RawanElsayed00/DAWG_ServoDriver_Board/DAWG_ServoDriver.kicad_pcb

## KiCad design DAWG_ServoDriver.kicad_pcb (2024-05-08)

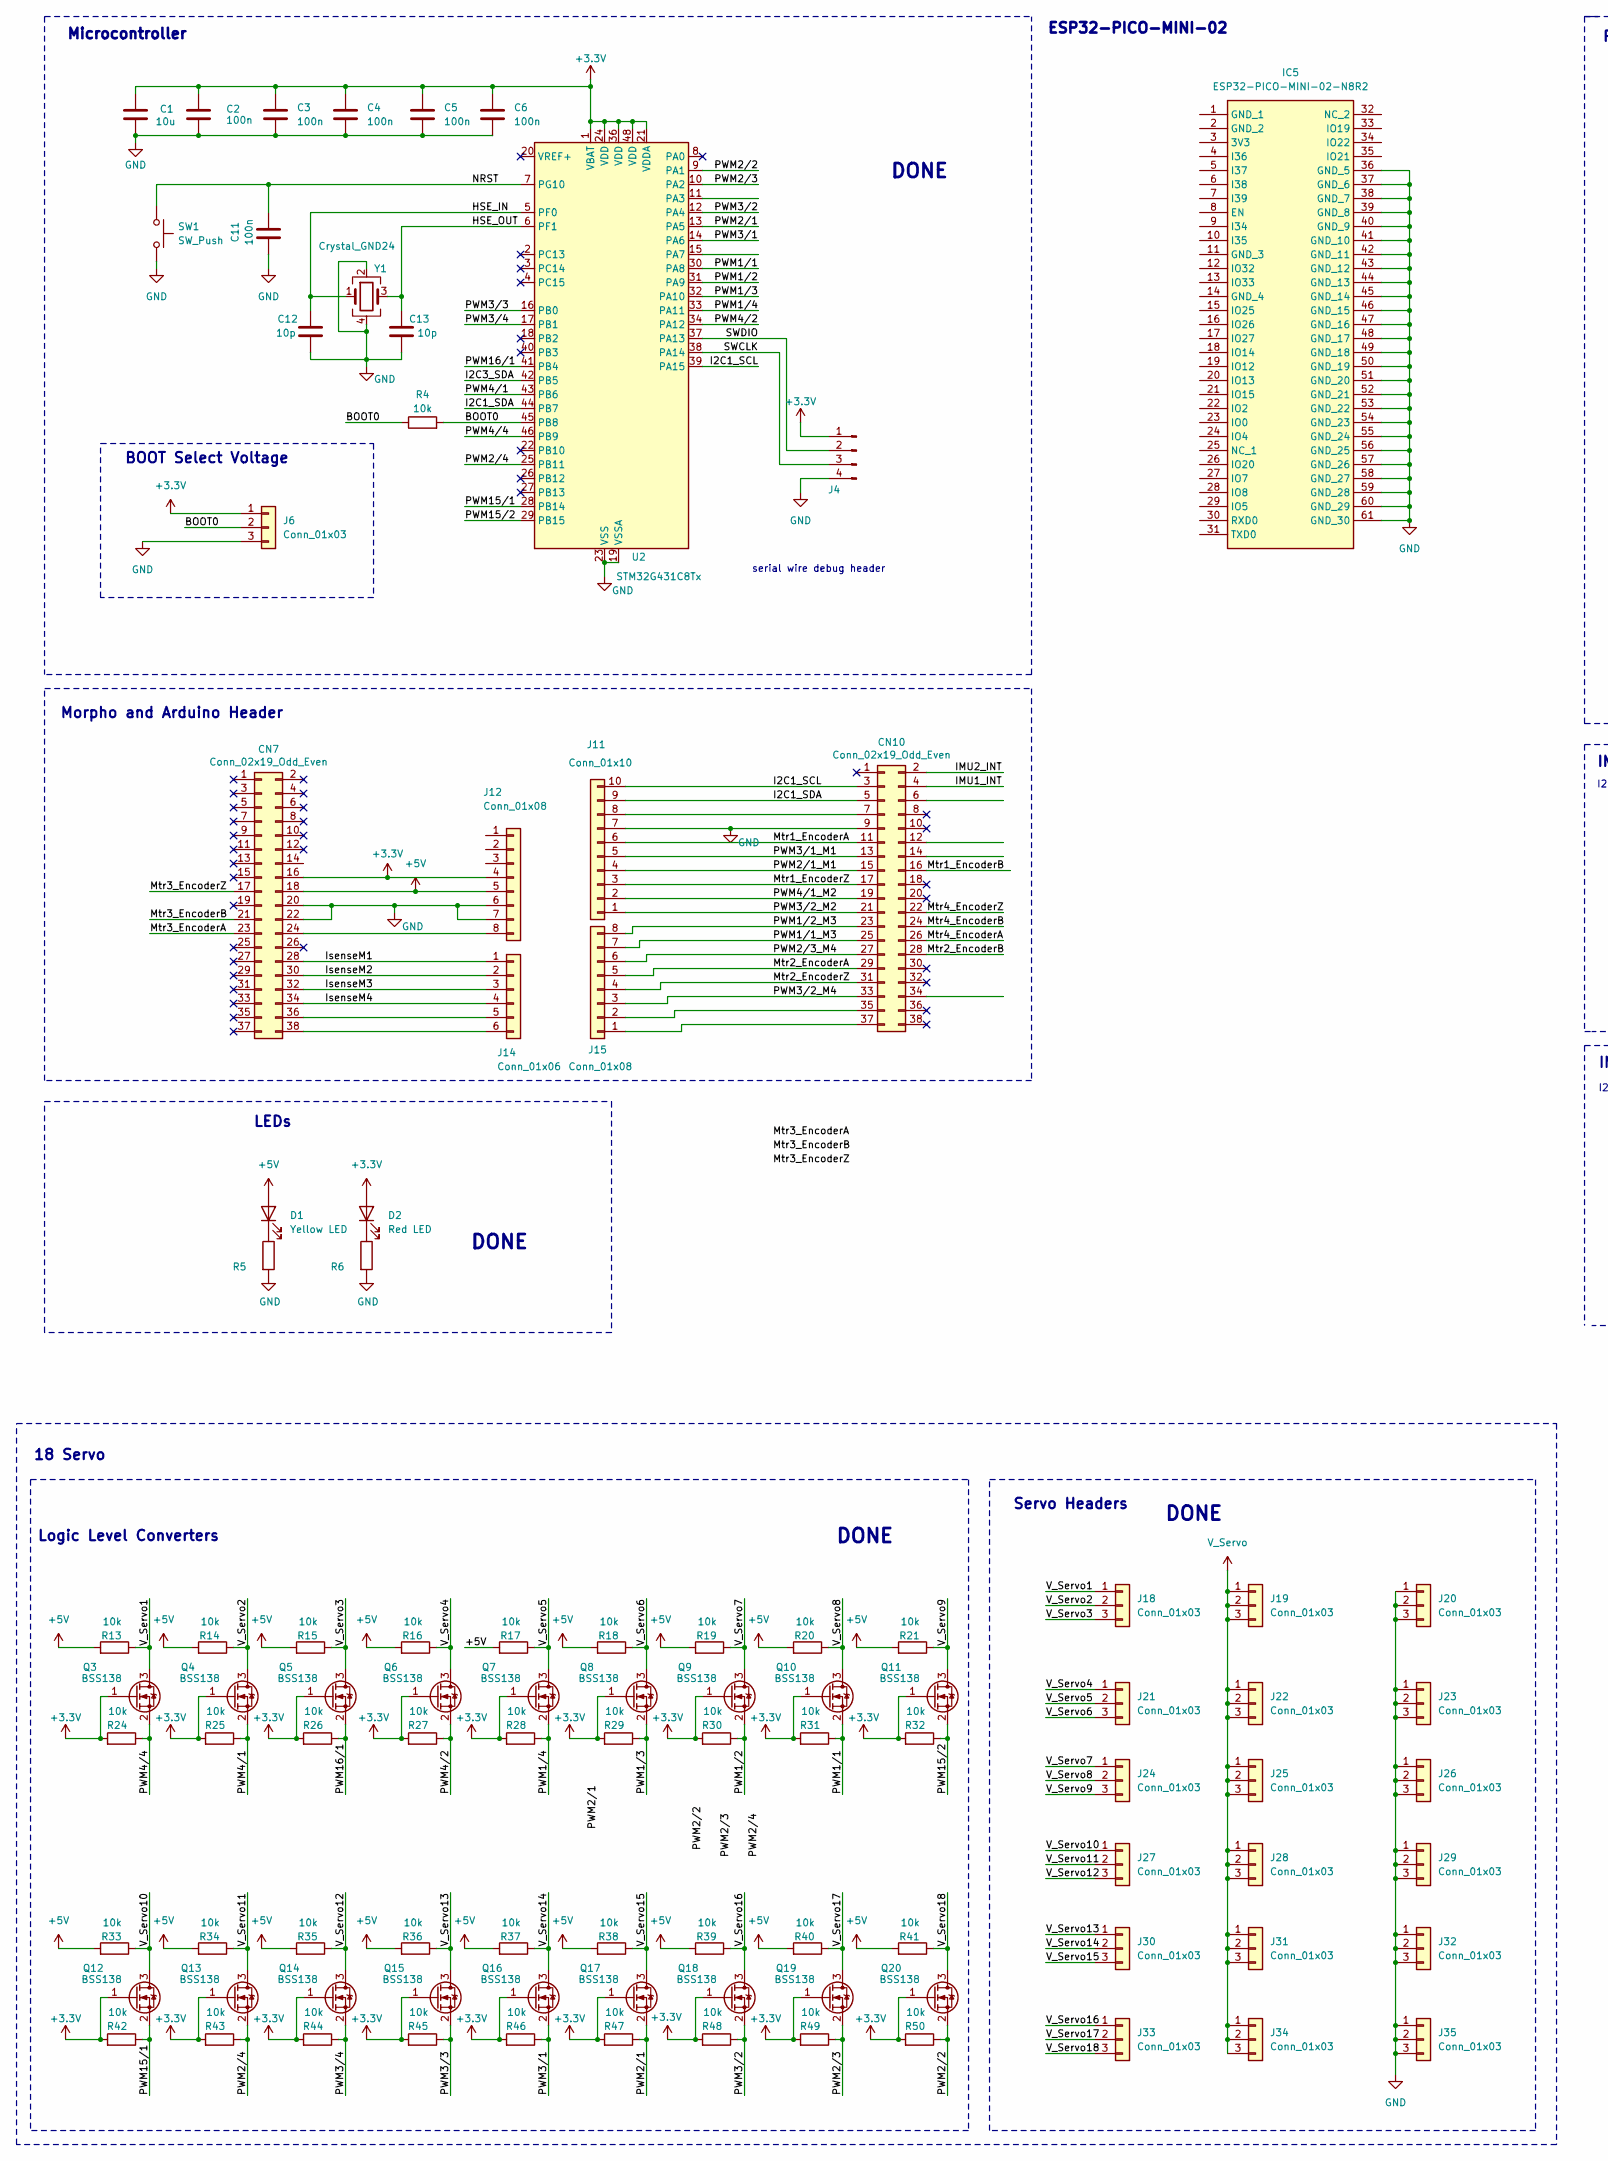
[picture p1: schematic DAWG_ServoDriver.kicad_sch, ServoDriver-STM32-Board, part in row 1, column 1]

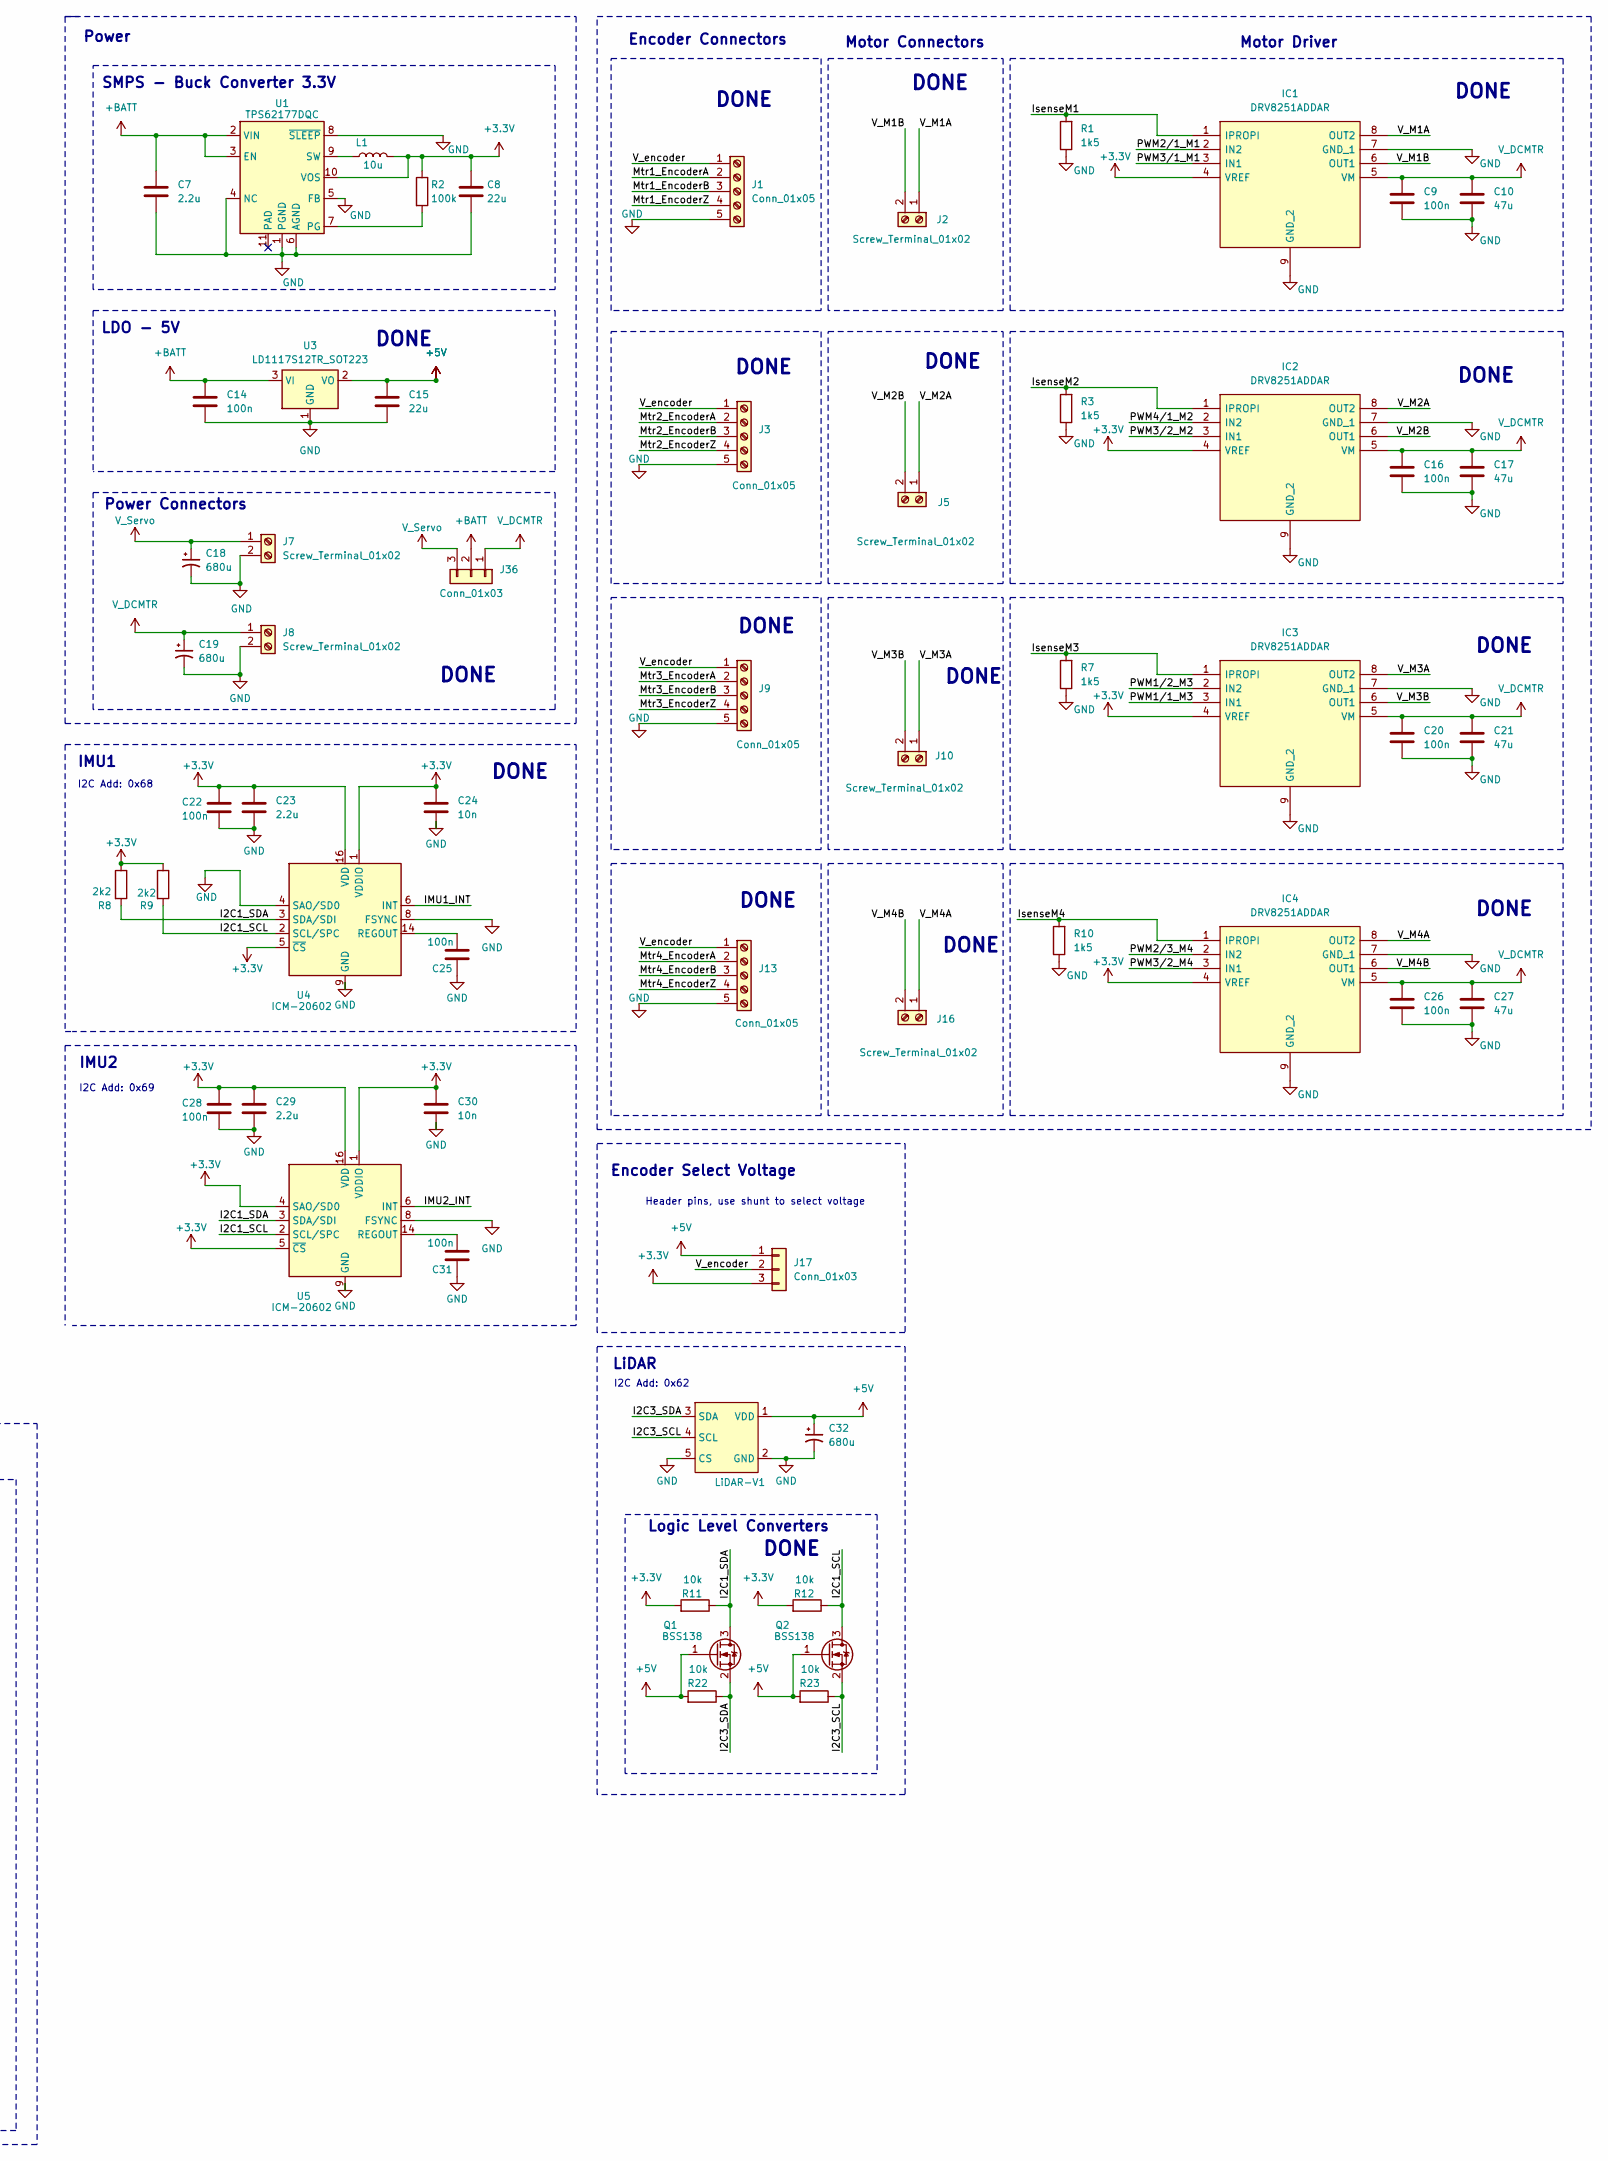
[picture p2: schematic DAWG_ServoDriver.kicad_sch, ServoDriver-STM32-Board, part in row 1, column 2]

Parts:
C1: 10u; C_0402_1005Metric_Pad0.74x0.62mm_HandSolder
C2, C3, C4, C5, C6, C9, C11, C14, C16, C20, C22, C25, C26, C28, C31: 100n; C_0402_1005Metric_Pad0.74x0.62mm_HandSolder
C7, C23, C29: 2.2u; C_0402_1005Metric_Pad0.74x0.62mm_HandSolder
C8, C15: 22u; C_0402_1005Metric_Pad0.74x0.62mm_HandSolder
C10, C17, C21, C27: 47u; C_1206_3216Metric_Pad1.33x1.80mm_HandSolder
C12, C13: 10p; C_0402_1005Metric_Pad0.74x0.62mm_HandSolder
C18, C19, C32: 680u; CP_Elec_10x10.5
C24, C30: 10n; C_0402_1005Metric_Pad0.74x0.62mm_HandSolder
CN7, CN10: Conn_02x19_Odd_Even; PinHeader_2x19_P2.54mm_Vertical
D1: Yellow LED; LED_0402_1005Metric_Pad0.77x0.64mm_HandSolder
D2: Red LED; LED_0402_1005Metric_Pad0.77x0.64mm_HandSolder
IC1, IC2, IC3, IC4: DRV8251ADDAR; SOIC127P600X170-9N; Mouser Part Number 595-DRV8251ADDAR
IC5: ESP32-PICO-MINI-02-N8R2; ESP32PICOMINI02N8R2; Mouser Part Number 356-ESP32PCOMN2PH3Q0
J1, J3, J9, J13: Conn_01x05; PinHeader_1x05_P2.54mm_Vertical
J2, J5, J10, J16: Screw_Terminal_01x02; PinHeader_1x02_P2.54mm_Vertical
J4: Conn_01x04_Pin; PinHeader_1x04_P2.54mm_Vertical
J6, J17, J18, J19, J20, J21, J22, J23, J24, J25, J26, J27, J28, J29, J30, J31, J32, J33, J34, J35, J36: Conn_01x03; PinHeader_1x03_P2.54mm_Vertical
J7, J8: Screw_Terminal_01x02; TerminalBlock_MetzConnect_Type701_RT11L02HGLU_1x02_P6.35mm_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
J11: Conn_01x10; PinHeader_1x10_P2.54mm_Vertical
J12, J15: Conn_01x08; PinHeader_1x08_P2.54mm_Vertical
J14: Conn_01x06; PinHeader_1x06_P2.54mm_Vertical
L1: 10u; L_0402_1005Metric_Pad0.77x0.64mm_HandSolder
LiDAR-V1: PinHeader_1x05_P2.54mm_Vertical
Q1, Q2, Q3, Q4, Q5, Q6, Q7, Q8, Q9, Q10, Q11, Q12, Q13, Q14, Q15, Q16, Q17, Q18, Q19, Q20: BSS138; SOT-23
R1, R3, R7, R10: 1k5; R_0402_1005Metric_Pad0.72x0.64mm_HandSolder
R2: 100k; R_0402_1005Metric_Pad0.72x0.64mm_HandSolder
R4, R11, R12, R13, R14, R15, R16, R17, R18, R19, R20, R21, R22, R23, R24, R25, R26, R27, R28, R29, R30, R31, R32, R33, R34, R35, R36, R37, R38, R39, R40, R41, R42, R43, R44, R45, R46, R47, R48, R49, R50: 10k; R_0402_1005Metric_Pad0.72x0.64mm_HandSolder
R5, R6: 100; R_0402_1005Metric_Pad0.72x0.64mm_HandSolder
R8, R9: 2k2; R_0402_1005Metric_Pad0.72x0.64mm_HandSolder
SW1: SW_Push; SW_Push_1P1T-SH_NO_CK_KMR2xxG
U1: TPS62177DQC; WSON-10-1EP_2x3mm_P0.5mm_EP0.84x2.4mm_ThermalVias
U2: STM32G431C8Tx; LQFP-48_7x7mm_P0.5mm
U3: LD1117S12TR_SOT223; SOT-223-3_TabPin2
U4, U5: ICM-20602; LGA-16_3x3mm_P0.5mm_LayoutBorder3x5y
Y1: Crystal_GND24; Crystal_SMD_2016-4Pin_2.0x1.6mm

Connections:
+3.3V: C1.1, C2.1, C3.1, C4.1, C5.1, C6.1, C8.1, C22.1, C23.1, C24.1, C28.1, C29.1, C30.1, CN7.16, D2.2 (A), IC1.4 (VREF), IC2.4 (VREF), IC3.4 (VREF), IC4.4 (VREF), J4.1, J6.1, J12.4, J17.3, L1.2, Q3.1 (G), Q4.1 (G), Q5.1 (G), Q6.1 (G), Q7.1 (G), Q8.1 (G), Q9.1 (G), Q10.1 (G), Q11.1 (G), Q12.1 (G), Q13.1 (G), Q14.1 (G), Q15.1 (G), Q16.1 (G), Q17.1 (G), Q18.1 (G), Q19.1 (G), Q20.1 (G), R2.1, R8.1, R9.1, R11.2, R12.2, R24.2, R25.2, R26.2, R27.2, R28.2, R29.2, R30.2, R31.2, R32.2, R42.2, R43.2, R44.2, R45.2, R46.2, R47.2, R48.2, R49.2, R50.2, U1.10 (VOS), U2.1 (VBAT), U2.21 (VDDA), U2.24 (VDD), U2.36 (VDD), U2.48 (VDD), U4.1 (VDDIO), U4.5 (~CS), U4.16 (VDD), U5.1 (VDDIO), U5.4 (SAO/SD0), U5.5 (~CS), U5.16 (VDD)
+5V: C15.2, C32.1, CN7.18, D1.2 (A), J12.5, J17.1, LiDAR-V1.1 (VDD), Q1.1 (G), Q2.1 (G), R13.2, R14.2, R15.2, R16.2, R17.2, R18.2, R19.2, R20.2, R21.2, R22.2, R23.2, R33.2, R34.2, R35.2, R36.2, R37.2, R38.2, R39.2, R40.2, R41.2, U3.2 (VO)
+BATT: C7.1, C14.2, J36.2, U1.2 (VIN), U1.3 (EN), U3.3 (VI)
/BOOT0: J6.2, R4.1, R4.2, U2.45 (PB8)
/HSE_IN: C12.1, U2.5 (PF0), Y1.1
/HSE_OUT: C13.1, U2.6 (PF1), Y1.3
/I2C1_SCL: CN10.3, J11.10, Q2.3 (D), R9.2, R12.1, U2.39 (PA15), U4.2 (SCL/SPC), U5.2 (SCL/SPC)
/I2C1_SDA: CN10.5, J11.9, Q1.3 (D), R8.2, R11.1, U2.44 (PB7), U4.3 (SDA/SDI), U5.3 (SDA/SDI)
/I2C3_SCL: LiDAR-V1.4 (SCL), Q2.2 (S), R23.1
/I2C3_SDA: LiDAR-V1.3 (SDA), Q1.2 (S), R22.1, U2.42 (PB5)
/IMU1_INT: CN10.4, U4.6 (INT)
/IMU2_INT: CN10.2, U5.6 (INT)
/IsenseM1: CN7.28, IC1.1 (IPROPI), J14.1, R1.2
/IsenseM2: CN7.30, IC2.1 (IPROPI), J14.2, R3.2
/IsenseM3: CN7.32, IC3.1 (IPROPI), J14.3, R7.2
/IsenseM4: CN7.34, IC4.1 (IPROPI), J14.4, R10.2
/Mtr1_EncoderA: CN10.11, J1.2, J11.6
/Mtr1_EncoderB: CN10.16, J1.3
/Mtr1_EncoderZ: CN10.17, J1.4, J11.3
/Mtr2_EncoderA: CN10.29, J3.2, J15.5
/Mtr2_EncoderB: CN10.28, J3.3
/Mtr2_EncoderZ: CN10.31, J3.4, J15.4
/Mtr3_EncoderA: CN7.23, J9.2
/Mtr3_EncoderB: CN7.21, J9.3
/Mtr3_EncoderZ: CN7.17, J9.4
/Mtr4_EncoderA: CN10.26, J13.2
/Mtr4_EncoderB: CN10.24, J13.3
/Mtr4_EncoderZ: CN10.22, J13.4
/NRST: C11.2, SW1.1, U2.7 (PG10)
/PWM1/1: Q10.2 (S), R31.1, U2.30 (PA8)
/PWM1/1_M3: CN10.25, IC3.3 (IN1), J15.7
/PWM1/2: Q9.2 (S), R30.1, U2.31 (PA9)
/PWM1/2_M3: CN10.23, IC3.2 (IN2), J15.8
/PWM1/3: Q8.2 (S), R29.1, U2.32 (PA10)
/PWM1/4: Q7.2 (S), R28.1, U2.33 (PA11)
/PWM2/1: Q17.2 (S), R47.1, U2.13 (PA5)
/PWM2/1_M1: CN10.15, IC1.2 (IN2), J11.4
/PWM2/2: Q20.2 (S), R50.1, U2.9 (PA1)
/PWM2/3: Q19.2 (S), R49.1, U2.10 (PA2)
/PWM2/3_M4: CN10.27, IC4.2 (IN2), J15.6
/PWM2/4: Q13.2 (S), R43.1, U2.25 (PB11)
/PWM3/1: Q16.2 (S), R46.1, U2.14 (PA6)
/PWM3/1_M1: CN10.13, IC1.3 (IN1), J11.5
/PWM3/2: Q18.2 (S), R48.1, U2.12 (PA4)
/PWM3/2_M2: CN10.21, IC2.3 (IN1), J11.1
/PWM3/2_M4: CN10.33, IC4.3 (IN1), J15.3
/PWM3/3: Q15.2 (S), R45.1, U2.16 (PB0)
/PWM3/4: Q14.2 (S), R44.1, U2.17 (PB1)
/PWM4/1: Q4.2 (S), R25.1, U2.43 (PB6)
/PWM4/1_M2: CN10.19, IC2.2 (IN2), J11.2
/PWM4/2: Q6.2 (S), R27.1, U2.34 (PA12)
/PWM4/4: Q3.2 (S), R24.1, U2.46 (PB9)
/PWM15/1: Q12.2 (S), R42.1, U2.28 (PB14)
/PWM15/2: Q11.2 (S), R32.1, U2.29 (PB15)
/PWM16/1: Q5.2 (S), R26.1, U2.41 (PB4)
/SWCLK: J4.3, U2.38 (PA14)
/SWDIO: J4.2, U2.37 (PA13)
/V_M1A: IC1.8 (OUT2), J2.1
/V_M1B: IC1.6 (OUT1), J2.2
/V_M2A: IC2.8 (OUT2), J5.1
/V_M2B: IC2.6 (OUT1), J5.2
/V_M3A: IC3.8 (OUT2), J10.1
/V_M3B: IC3.6 (OUT1), J10.2
/V_M4A: IC4.8 (OUT2), J16.1
/V_M4B: IC4.6 (OUT1), J16.2
/V_Servo1: J18.1, Q3.3 (D), R13.1
/V_Servo2: J18.2, Q4.3 (D), R14.1
/V_Servo3: J18.3, Q5.3 (D), R15.1
/V_Servo4: J21.1, Q6.3 (D), R16.1
/V_Servo5: J21.2, Q7.3 (D), R17.1
/V_Servo6: J21.3, Q8.3 (D), R18.1
/V_Servo7: J24.1, Q9.3 (D), R19.1
/V_Servo8: J24.2, Q10.3 (D), R20.1
/V_Servo9: J24.3, Q11.3 (D), R21.1
/V_Servo10: J27.1, Q12.3 (D), R33.1
/V_Servo11: J27.2, Q13.3 (D), R34.1
/V_Servo12: J27.3, Q14.3 (D), R35.1
/V_Servo13: J30.1, Q15.3 (D), R36.1
/V_Servo14: J30.2, Q16.3 (D), R37.1
/V_Servo15: J30.3, Q17.3 (D), R38.1
/V_Servo16: J33.1, Q18.3 (D), R39.1
/V_Servo17: J33.2, Q19.3 (D), R40.1
/V_Servo18: J33.3, Q20.3 (D), R41.1
/V_encoder: J1.1, J3.1, J9.1, J13.1, J17.2
GND: C1.2, C2.2, C3.2, C4.2, C5.2, C6.2, C7.2, C8.2, C9.1, C10.1, C11.1, C12.2, C13.2, C14.1, C15.1, C16.1, C17.1, C18.2, C19.2, C20.1, C21.1, C22.2, C23.2, C24.2, C25.1, C26.1, C27.1, C28.2, C29.2, C30.2, C31.1, C32.2, CN7.20, CN7.22, CN10.9, IC1.7 (GND_1), IC1.9 (GND_2), IC2.7 (GND_1), IC2.9 (GND_2), IC3.7 (GND_1), IC3.9 (GND_2), IC4.7 (GND_1), IC4.9 (GND_2), IC5.36 (GND_5), IC5.37 (GND_6), IC5.38 (GND_7), IC5.39 (GND_8), IC5.40 (GND_9), IC5.41 (GND_10), IC5.42 (GND_11), IC5.43 (GND_12), IC5.44 (GND_13), IC5.45 (GND_14), IC5.46 (GND_15), IC5.47 (GND_16), IC5.48 (GND_17), IC5.49 (GND_18), IC5.50 (GND_19), IC5.51 (GND_20), IC5.52 (GND_21), IC5.53 (GND_22), IC5.54 (GND_23), IC5.55 (GND_24), IC5.56 (GND_25), IC5.57 (GND_26), IC5.58 (GND_27), IC5.59 (GND_28), IC5.60 (GND_29), IC5.61 (GND_30), J1.5, J3.5, J4.4, J6.3, J7.2, J8.2, J9.5, J11.7, J12.6, J12.7, J13.5, J20.1, J20.2, J20.3, J23.1, J23.2, J23.3, J26.1, J26.2, J26.3, J29.1, J29.2, J29.3, J32.1, J32.2, J32.3, J35.1, J35.2, J35.3, LiDAR-V1.2 (GND), LiDAR-V1.5 (CS), R1.1, R3.1, R5.2, R6.2, R7.1, R10.1, SW1.2, U1.1 (PGND), U1.4 (NC), U1.5 (FB), U1.6 (AGND), U1.8 (~SLEEP), U2.19 (VSSA), U2.23 (VSS), U2.35 (VSS), U2.47 (VSS), U3.1 (GND), U4.4 (SAO/SD0), U4.8 (FSYNC), U4.9 (GND), U4.10 (GND), U4.11 (GND), U4.12 (GND), U4.13 (GND), U4.15 (GND), U5.8 (FSYNC), U5.9 (GND), U5.10 (GND), U5.11 (GND), U5.12 (GND), U5.13 (GND), U5.15 (GND), Y1.2, Y1.4
unnamed: CN7.24, J12.8
unnamed: CN7.36, J14.5
unnamed: CN7.38, J14.6
unnamed: CN10.7, J11.8
unnamed: CN10.35, J15.2
unnamed: CN10.37, J15.1
unnamed: D1.1 (K), R5.1
unnamed: D2.1 (K), R6.1
unnamed: R2.2, U1.7 (PG)
unnamed: L1.1, U1.9 (SW)
unnamed: C25.2, U4.14 (REGOUT)
unnamed: C31.2, U5.14 (REGOUT)
V_DCMTR: C9.2, C10.2, C16.2, C17.2, C19.1, C20.2, C21.2, C26.2, C27.2, IC1.5 (VM), IC2.5 (VM), IC3.5 (VM), IC4.5 (VM), J8.1, J36.1
V_Servo: C18.1, J7.1, J19.1, J19.2, J19.3, J22.1, J22.2, J22.3, J25.1, J25.2, J25.3, J28.1, J28.2, J28.3, J31.1, J31.2, J31.3, J34.1, J34.2, J34.3, J36.3

Notes on the sheet:
DONE
Encoder Connectors
Servo Headers
Logic Level Converters
Power Connectors
ESP32-PICO-MINI-02
Encoder Select Voltage
I2C Add: 0x69
LiDAR
LDO - 5V
BOOT Select Voltage
IMU2
LEDs
Logic Level Converters
serial wire debug header
I2C Add: 0x62
Power
SMPS - Buck Converter 3.3V
I2C Add: 0x68
Header pins, use shunt to select voltage
Motor Driver
Microcontroller
IMU1
18 Servo
Motor Connectors
Morpho and Arduino Header

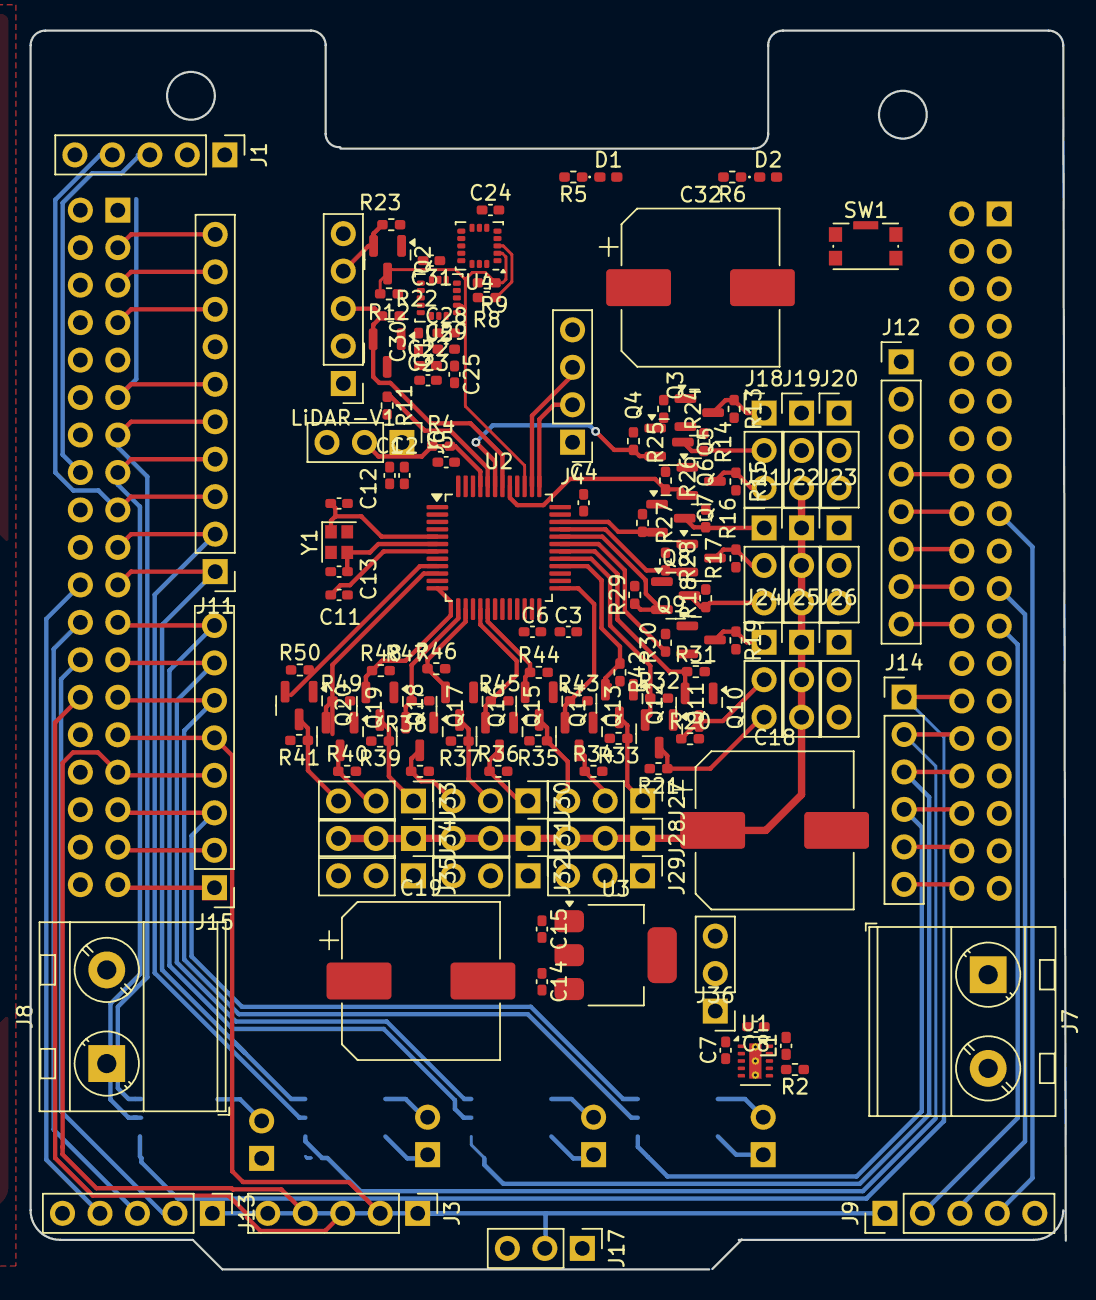
[picture p3: board DAWG_ServoDriver.kicad_pcb from above]

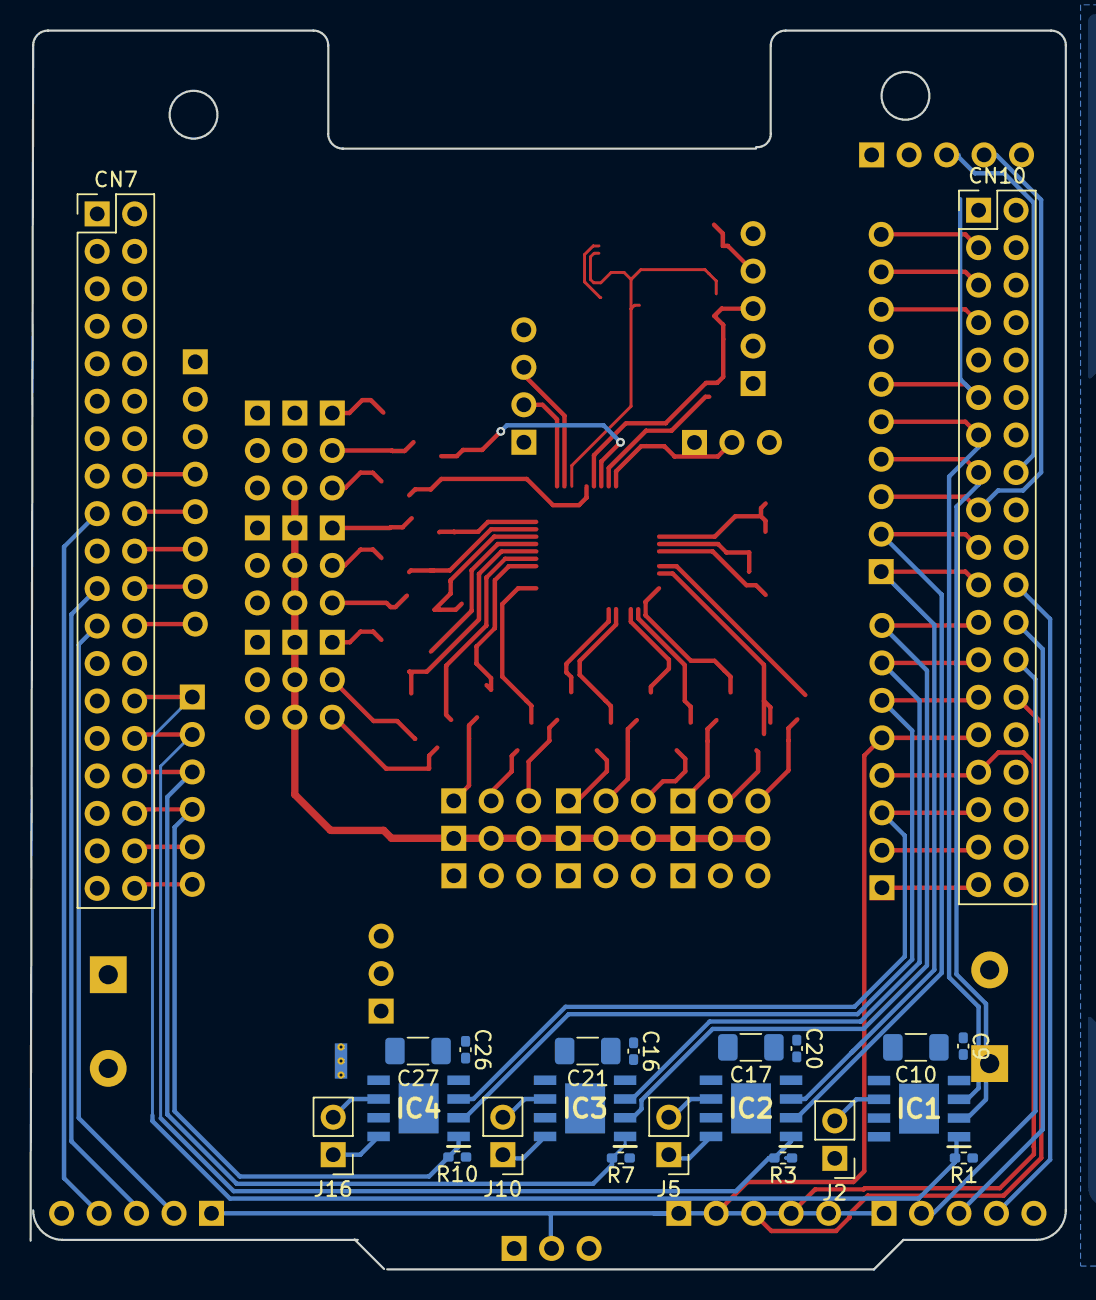
[picture p4: board DAWG_ServoDriver.kicad_pcb from below]

Board: 2 copper layers, 70.2 x 84.0 mm, 155 parts (22 on the bottom side), 99 nets.
