RawanElsayed00/DAWG_ServoDriver_Board/(commit log)

2024-04-06 Initial Commit Schematic Draft
    [DAWG_ServoDriver.kicad_pcb, DAWG_ServoDriver.kicad_sch]
2024-04-07 Your commit message
    [DAWG_ServoDriver.kicad_sch]
2024-04-07 Updated IMU, Added Motor Drivers and screw terminal, Added the morpho header
    [DAWG_ServoDriver.kicad_sch]
2024-04-07 Added motor driver resistor values and arranged components
    [DAWG_ServoDriver.kicad_sch]
2024-04-08 Added footprints for all except SW1, SW2, ServoHeader, crystal
    [DAWG_ServoDriver.kicad_sch]
2024-04-08 Added Arduino connectors and LEDs. Changed servo footprint and power in labels.
    [DAWG_ServoDriver.kicad_sch]
2024-04-08 Started PCB, alligned and placed microcontroller components
    [DAWG_ServoDriver.kicad_pcb, DAWG_ServoDriver.kicad_sch]
2024-04-09 Placed mos most components, routed servo.
    [DAWG_ServoDriver.kicad_pcb, DAWG_ServoDriver.kicad_sch]
2024-04-11 Finished Routing all except IMU2_INT and GNDs
    [DAWG_ServoDriver.kicad_pcb]
2024-05-08 Merges pull request
    [DAWG_ServoDriver.kicad_pcb, DAWG_ServoDriver.kicad_sch]
